vikulin/Fugu2/(commit log)

2026-07-17 Fixed DRC errors https://github.com/vikulin/Fugu2/issues/1
    See https://github.com/vikulin/Fugu2/issues/1 for a detailed report
    [Fugu2.kicad_pcb]
2026-07-17 Add RC connection between USB-C shield and GND
    1. Added a 1 MΩ resistor and 10 nF capacitor between the USB Type-C connector shield and GND in the schematic and PCB layout.
    2. Added clearer USB connector symbol having no missing pads
    [Fugu2.kicad_pcb, Fugu2.kicad_sch, GateDrive.kicad_sch, PowerSupply.kicad_sch, Sensors.kicad_sch, uC.kicad_sch]
2026-07-17 Add project attributions: LICENSE. project name, HW version, Authors
    LICENSE: Solderpad Hardware License v2.1
    project name: Fugu2
    HW version: v2,4
    Authors: Fabian, Vadym Vikulin
    [Fugu2.kicad_pcb, Fugu2.kicad_sch, GateDrive.kicad_sch, PowerSupply.kicad_sch, Sensors.kicad_sch, uC.kicad_sch]
